beyarkay/vvim/img/2021-06-29 plots/b_500ms.png

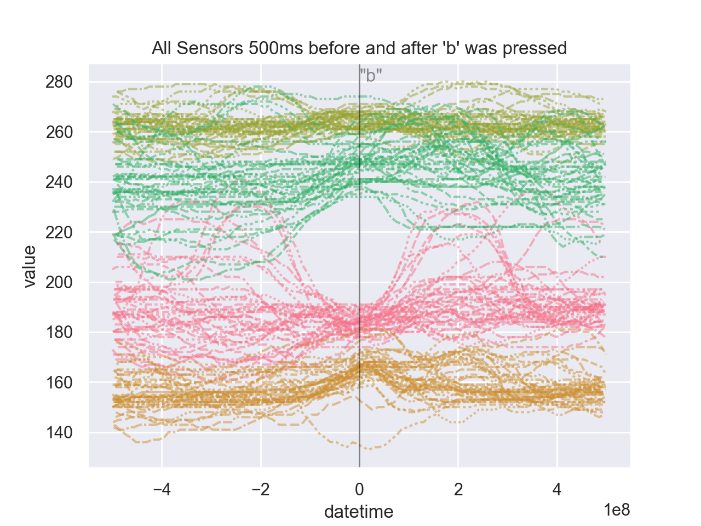
img/2021-06-29 plots/b_500ms.png
