beyarkay/vvim/img/2021-06-29 plots/j_500ms.png

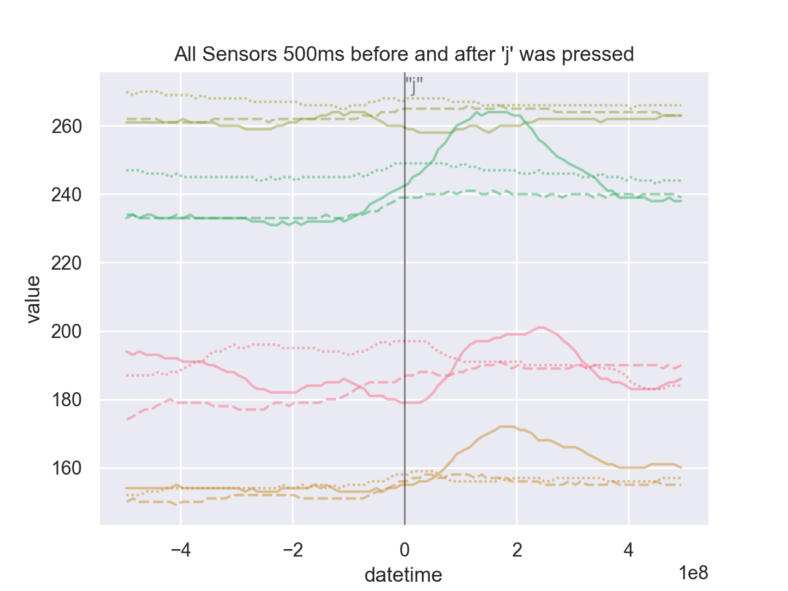
img/2021-06-29 plots/j_500ms.png
