beyarkay/vvim/img/2021-06-29 plots/k_500ms.png

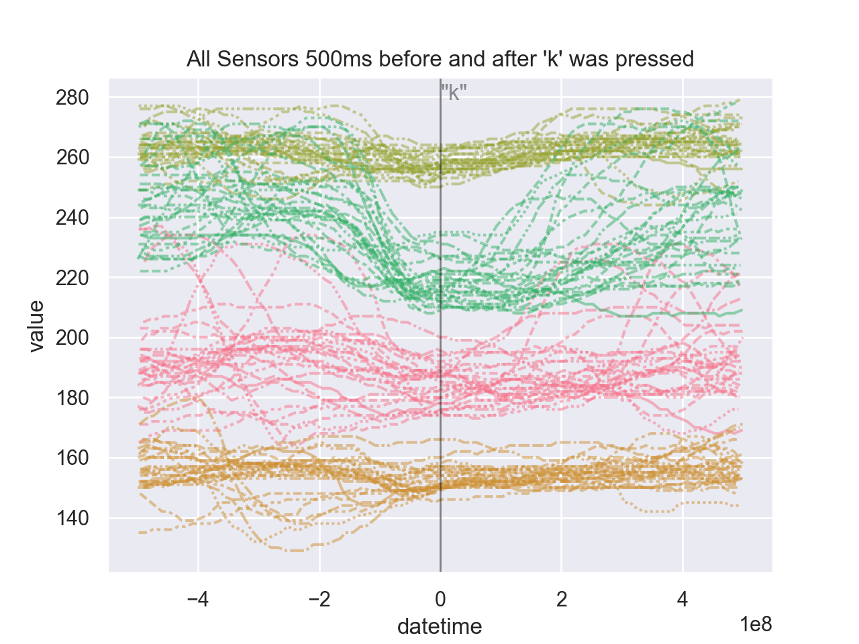
img/2021-06-29 plots/k_500ms.png
