beyarkay/vvim/img/2021-06-29 plots/m_500ms.png

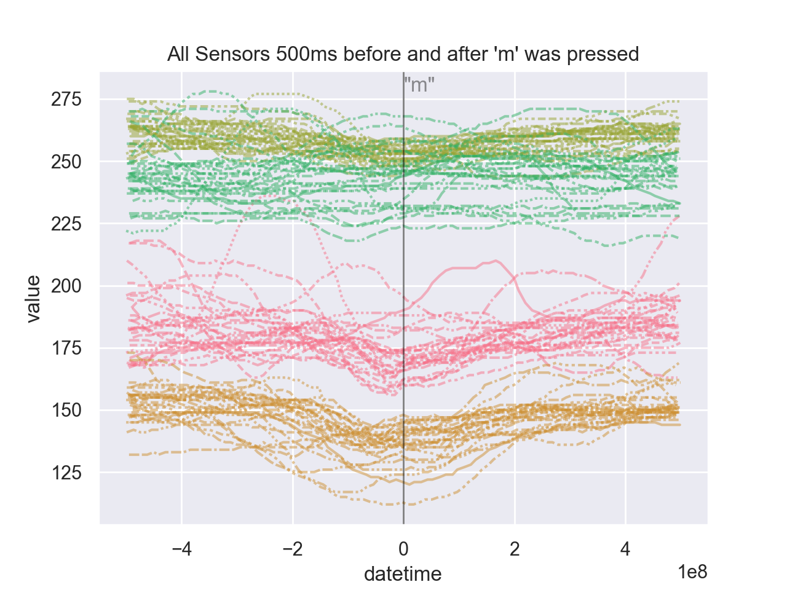
img/2021-06-29 plots/m_500ms.png
