beyarkay/vvim/img/2021-06-30 plots/b_500ms.png

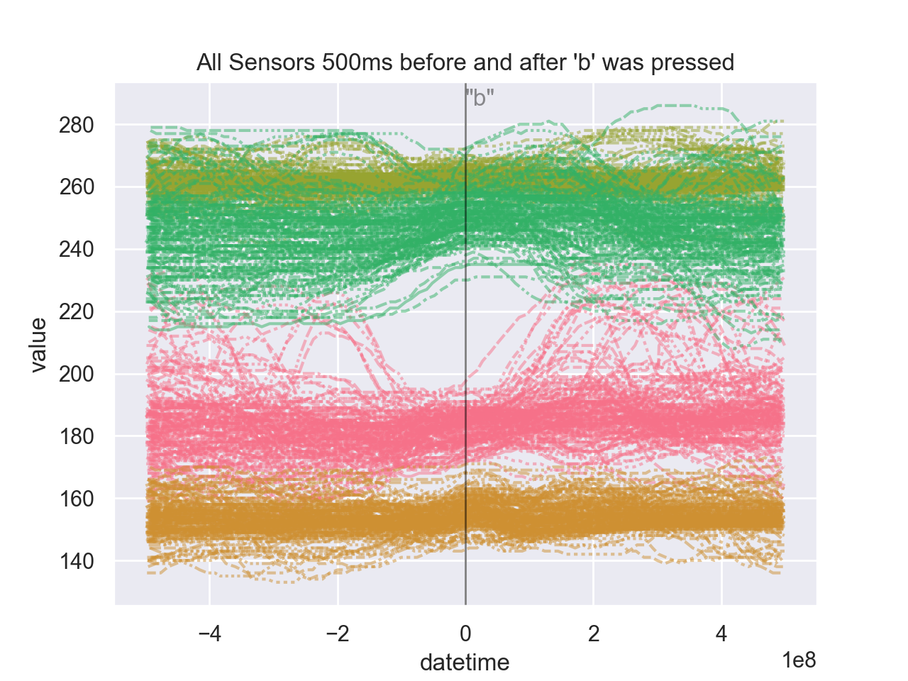
img/2021-06-30 plots/b_500ms.png
