beyarkay/vvim/img/2021-06-30 plots/m_500ms.png

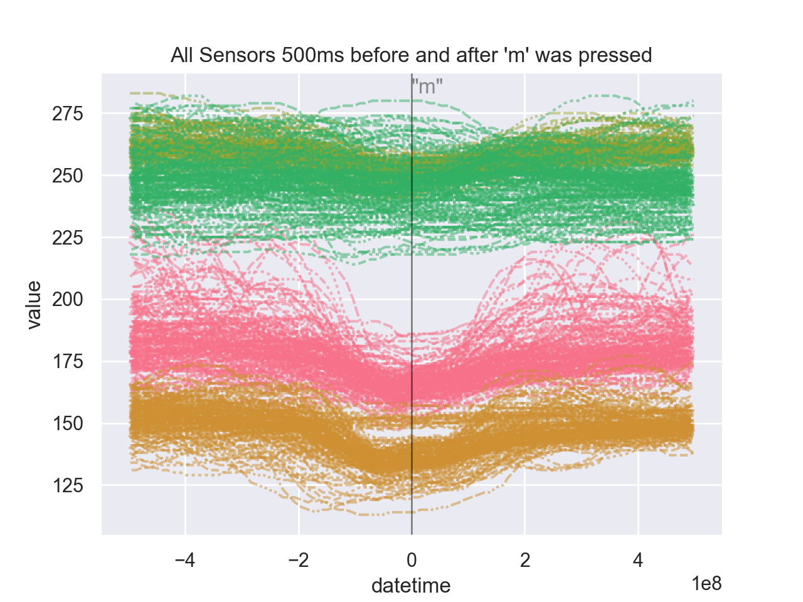
img/2021-06-30 plots/m_500ms.png
