beyarkay/vvim/img/confusion_matrix.png

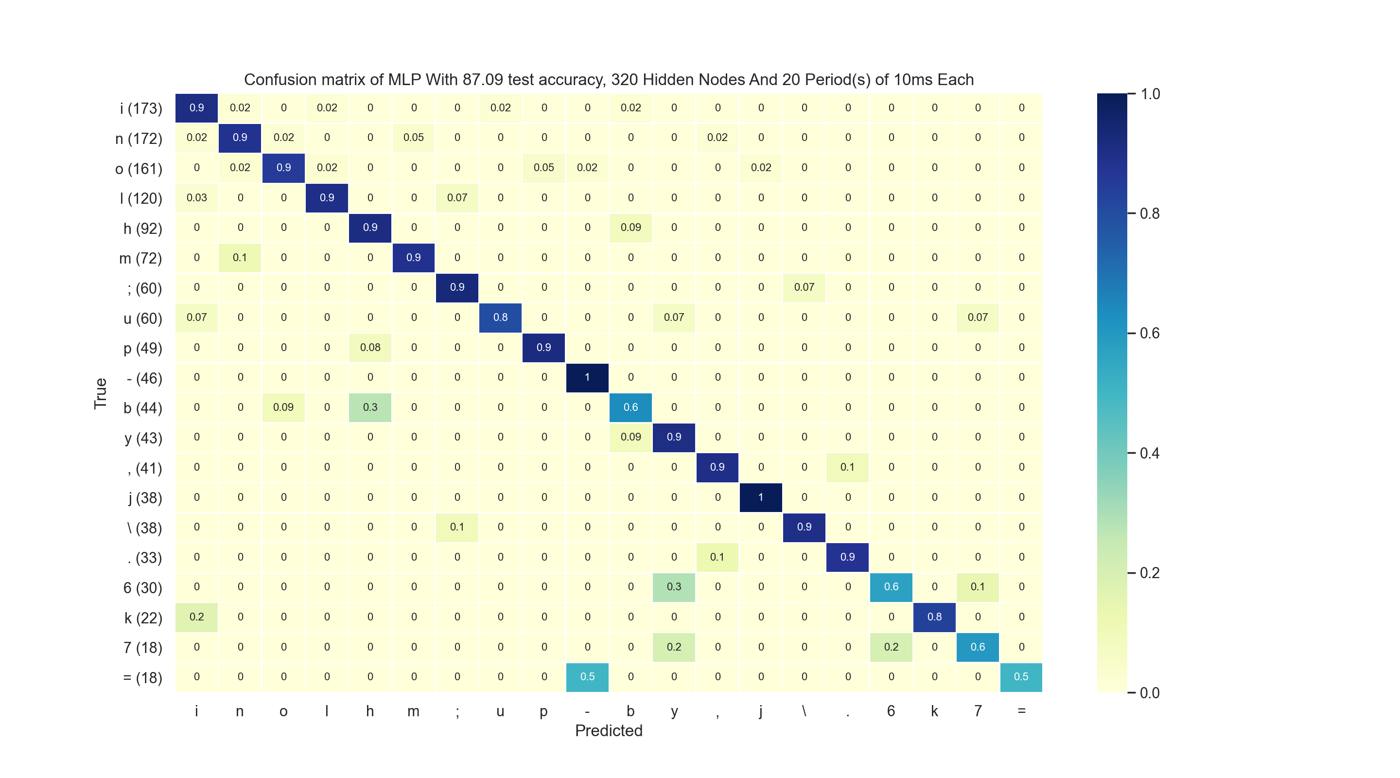
img/confusion_matrix.png
