beyarkay/vvim/img/correlations.png

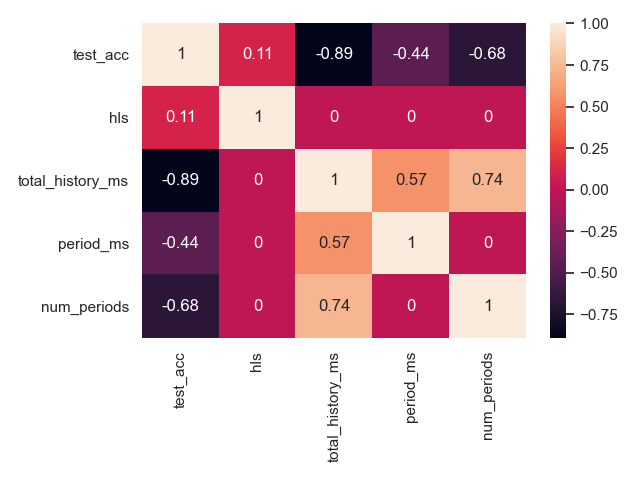
img/correlations.png
