beyarkay/vvim/img/images/confusion.png

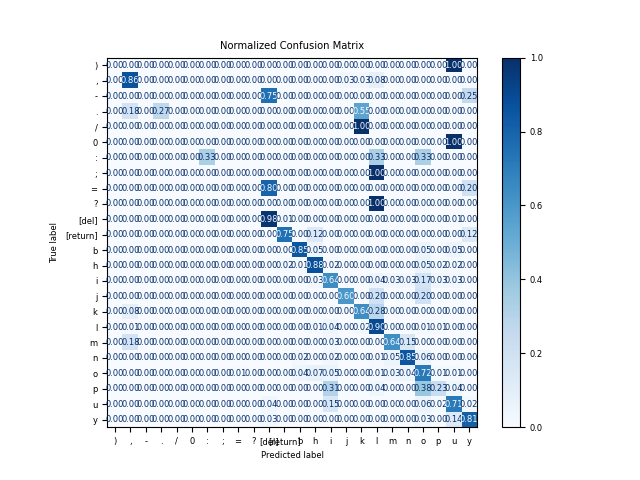
img/images/confusion.png
