beyarkay/vvim/img/images/ConfusionMatrixKNN_3.png

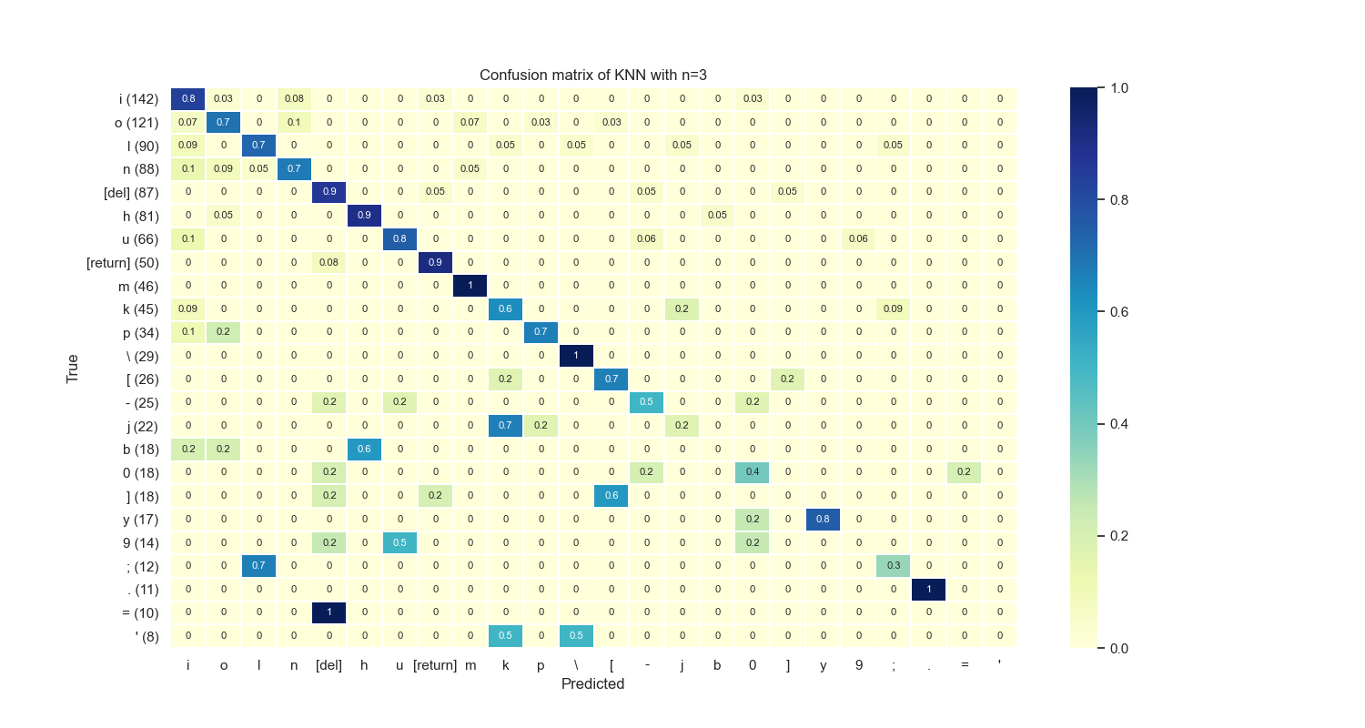
img/images/ConfusionMatrixKNN_3.png
