beyarkay/vvim/img/images/ConfusionMatrixMLP_29.png

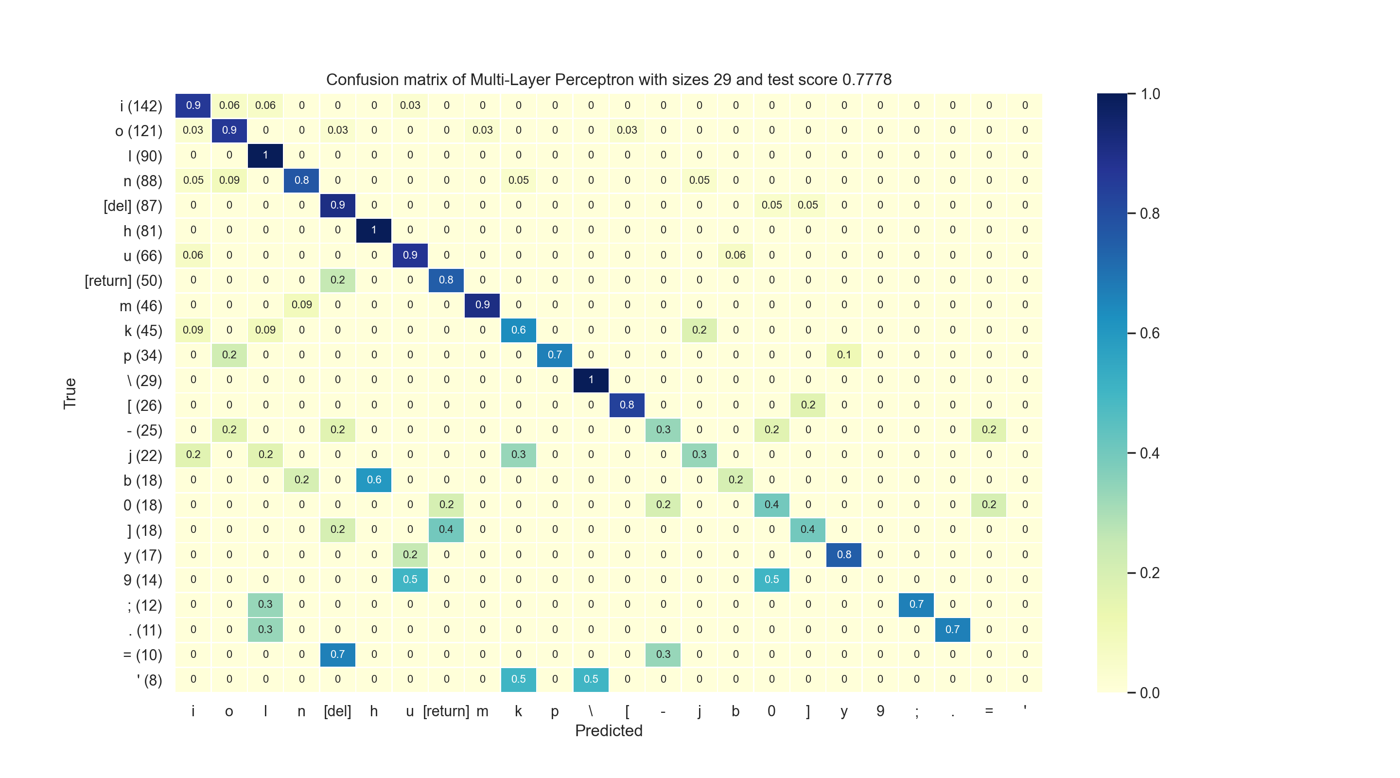
img/images/ConfusionMatrixMLP_29.png
