beyarkay/vvim/img/images/ConfusionMatrixRandomForest.png

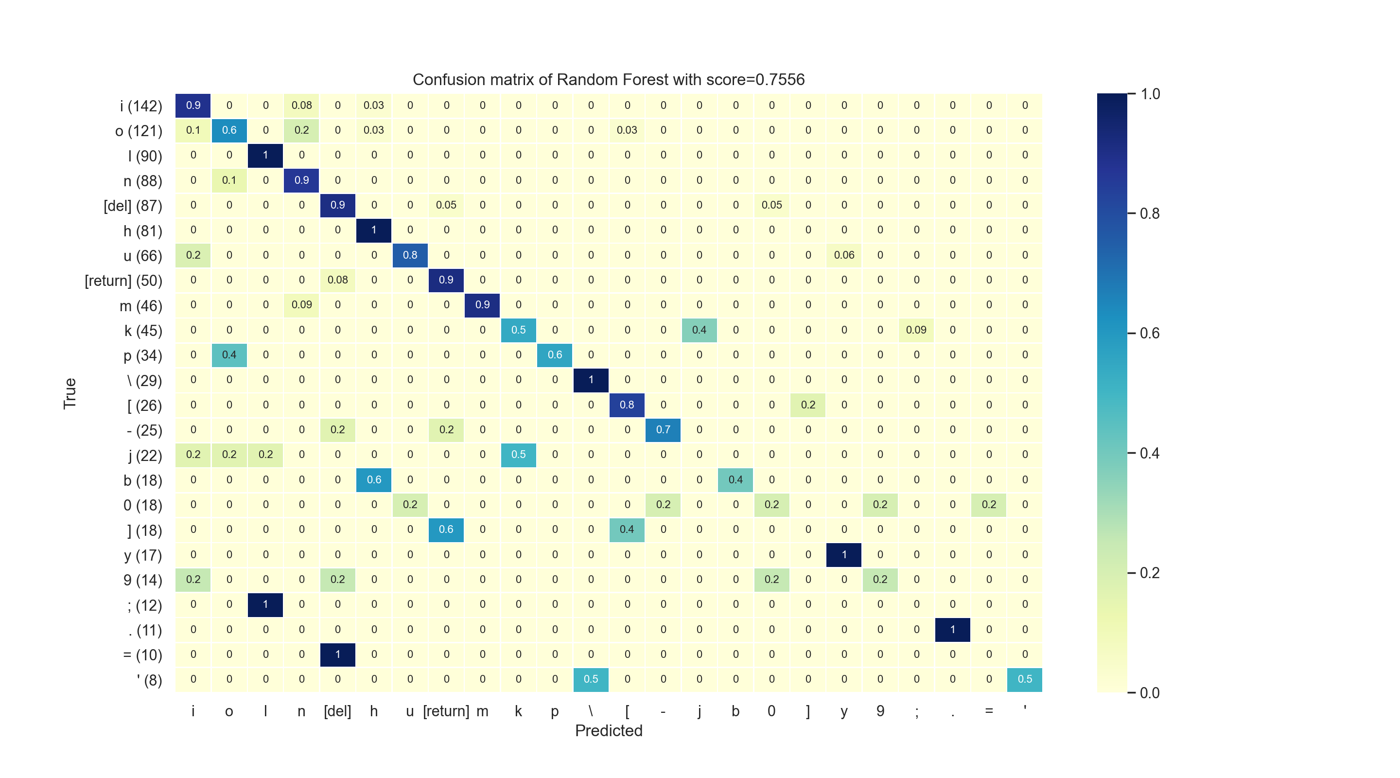
img/images/ConfusionMatrixRandomForest.png
