beyarkay/vvim/img/images/finger_data_more.png

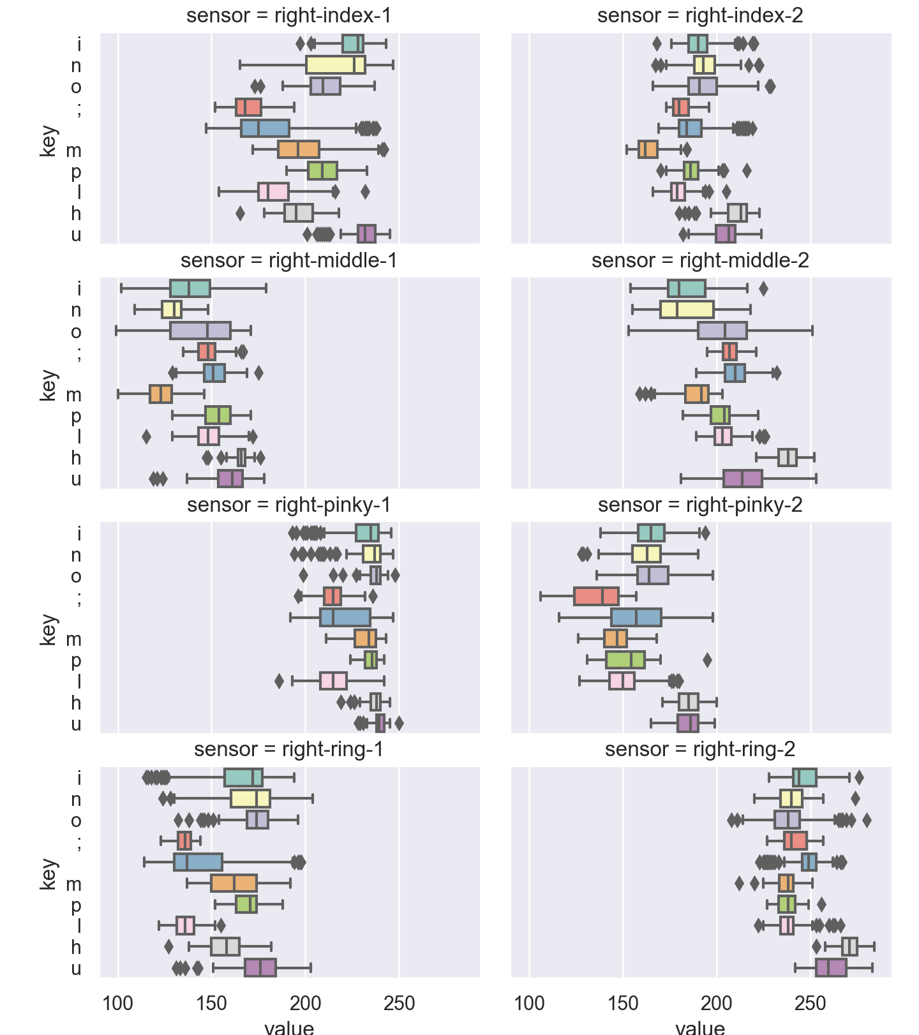
img/images/finger_data_more.png
