beyarkay/vvim/img/images/glove_square.jpg

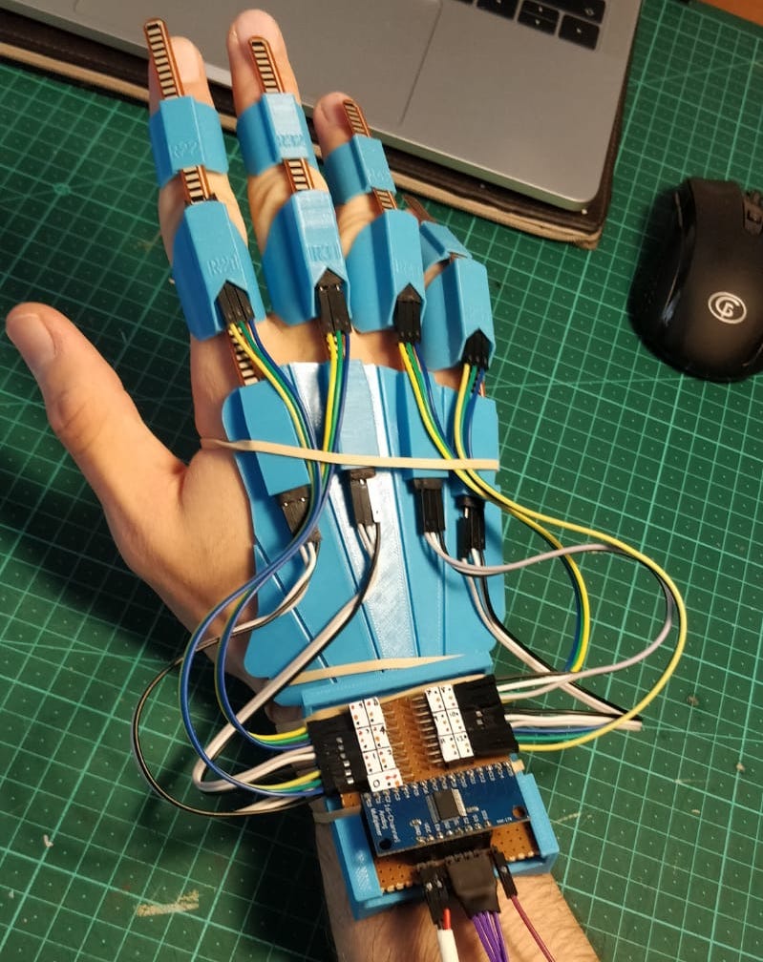
img/images/glove_square.jpg
