beyarkay/vvim/img/images/glove_V0.jpg

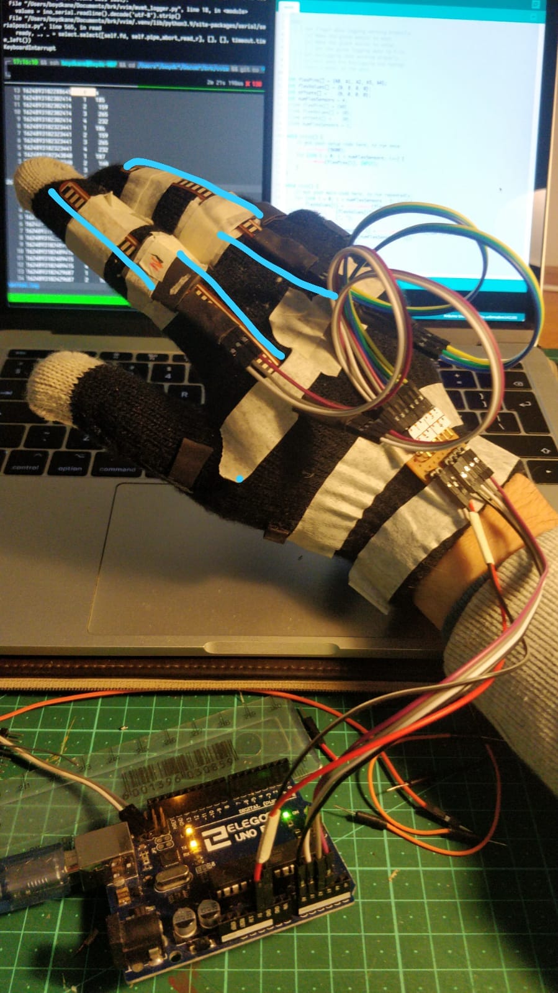
img/images/glove_V0.jpg
