beyarkay/vvim/img/images/polarplot.png

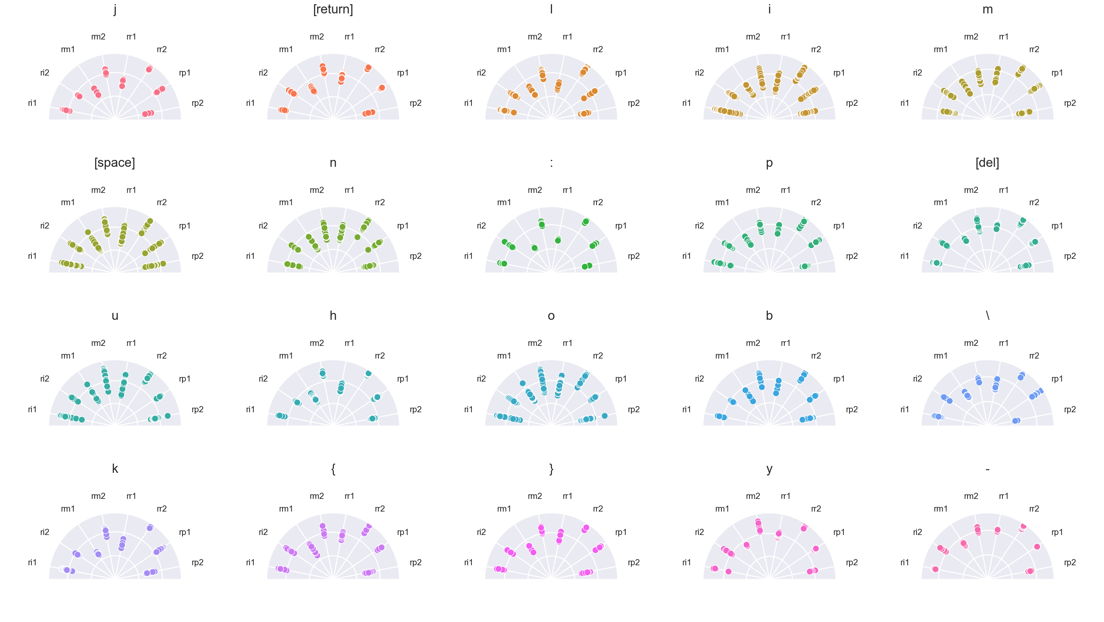
img/images/polarplot.png
