beyarkay/vvim/img/images/small_confusion.jpg

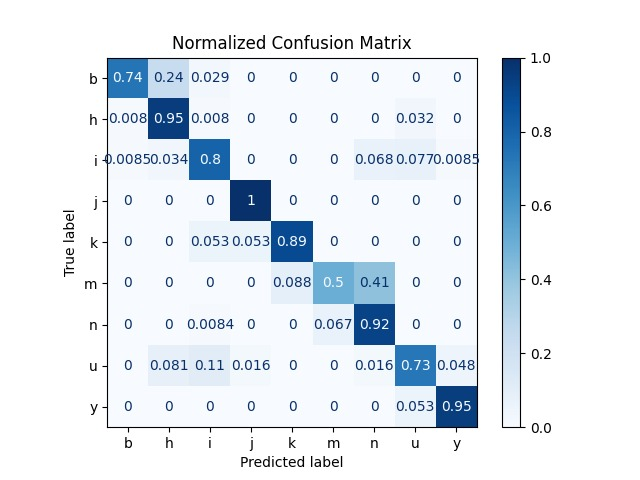
img/images/small_confusion.jpg
