beyarkay/vvim/img/pairwise r=hls,c=period_ms,x=num_periods.png

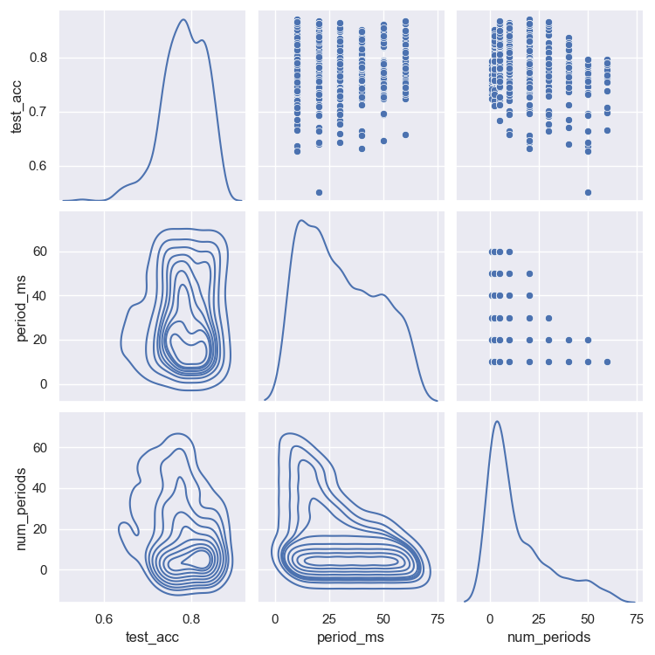
img/pairwise r=hls,c=period_ms,x=num_periods.png
