beyarkay/vvim/img/plots/[_500ms.png

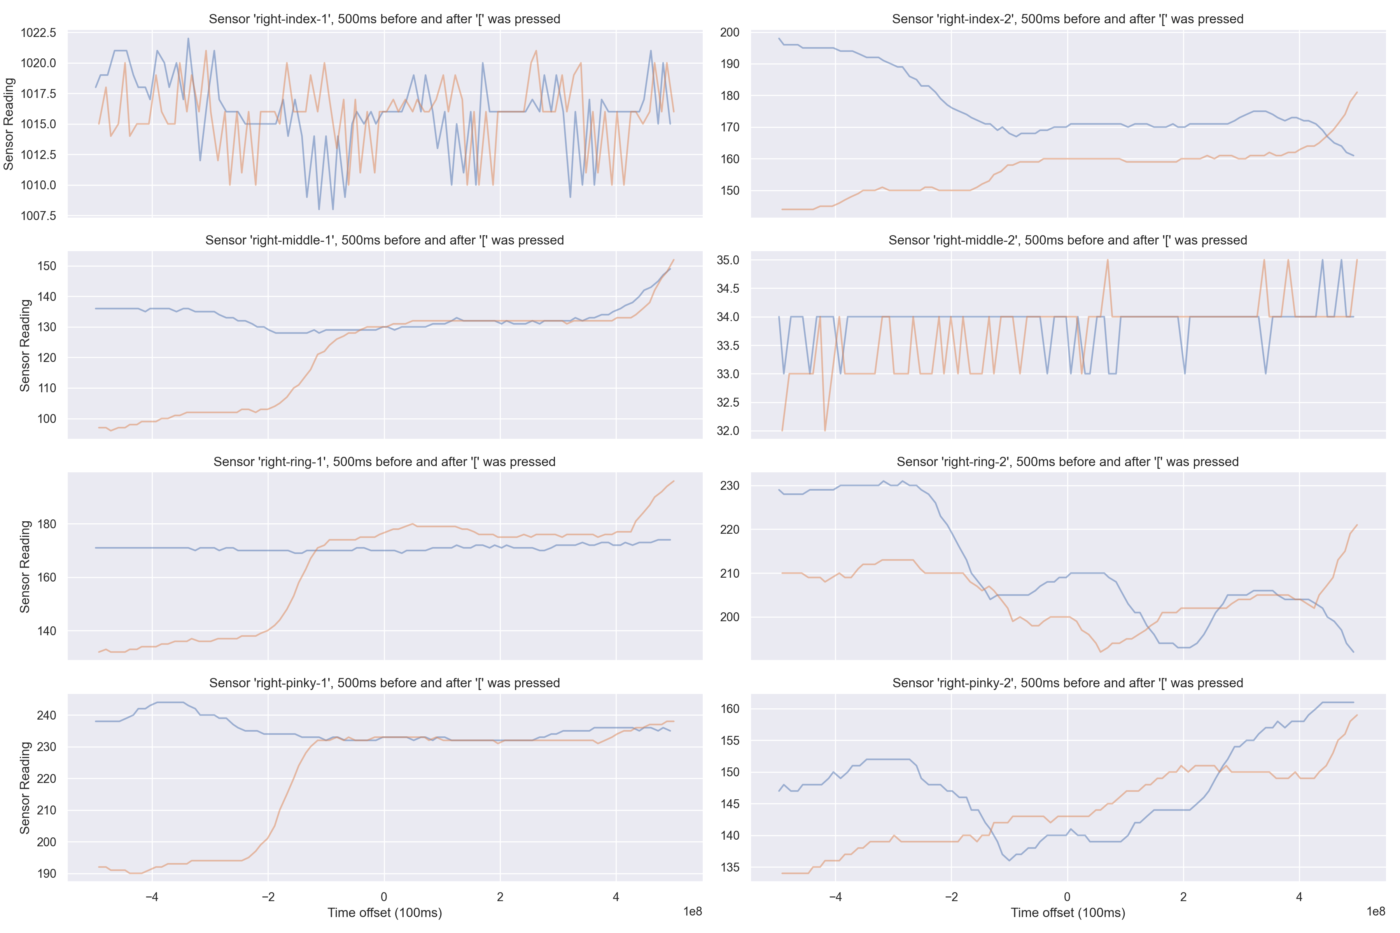
img/plots/[_500ms.png
