beyarkay/vvim/img/plots/b_500ms.png

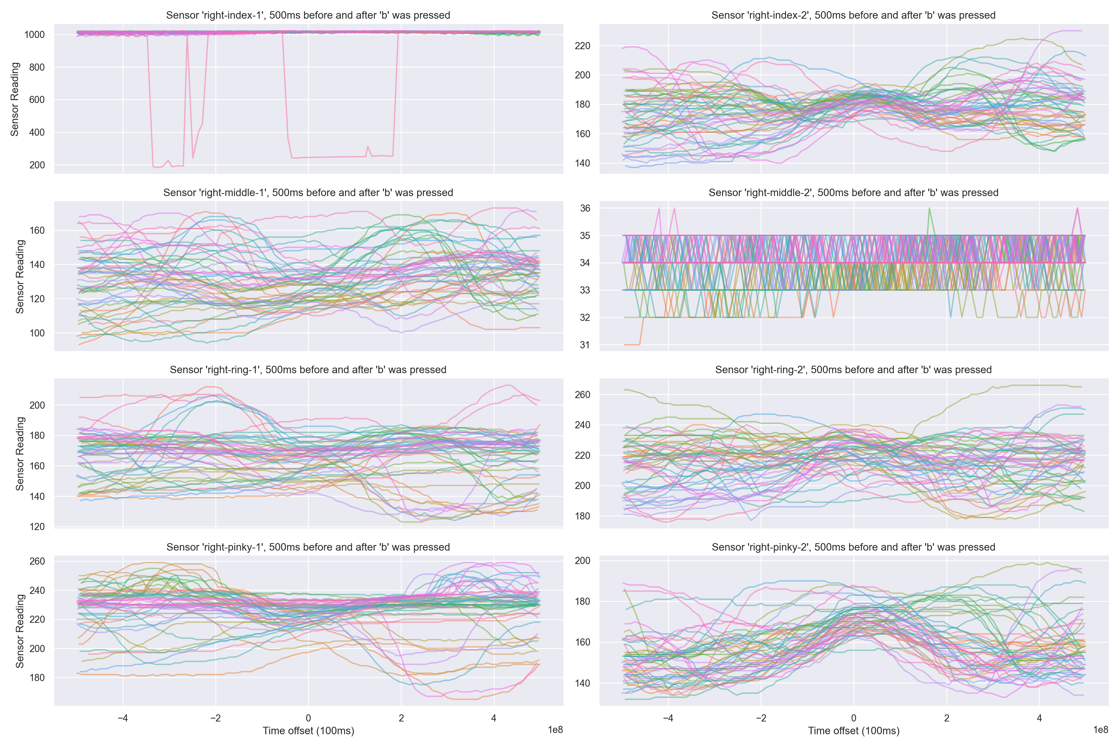
img/plots/b_500ms.png
