beyarkay/vvim/img/plots/n_500ms.png

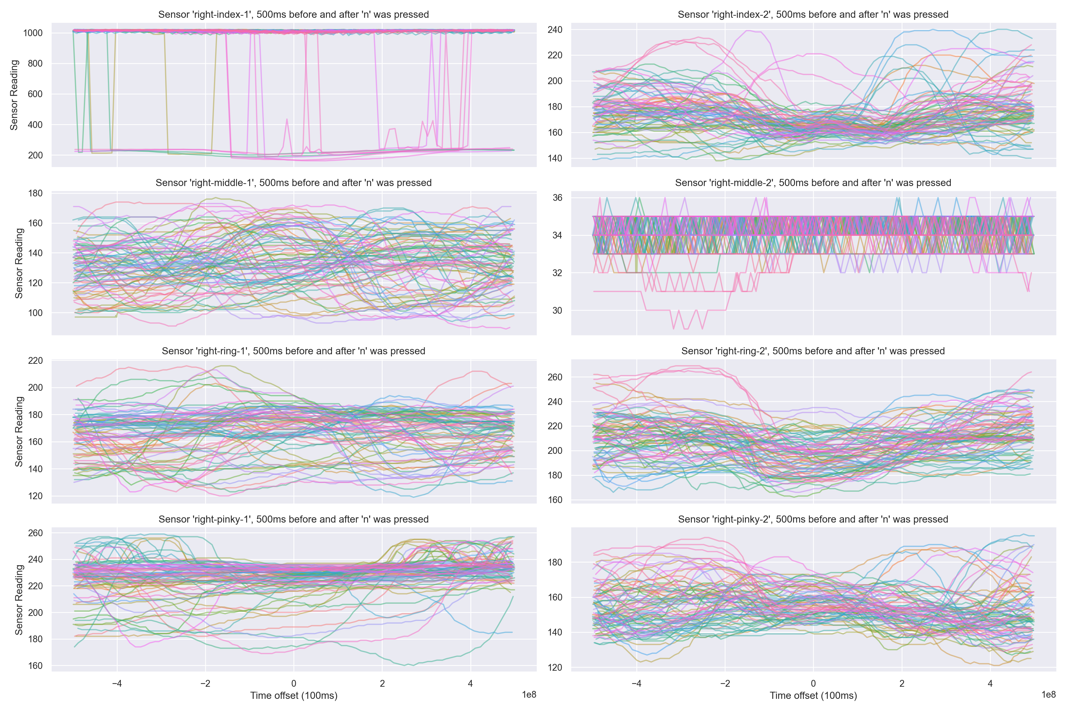
img/plots/n_500ms.png
