beyarkay/vvim/img/plots/p_500ms.png

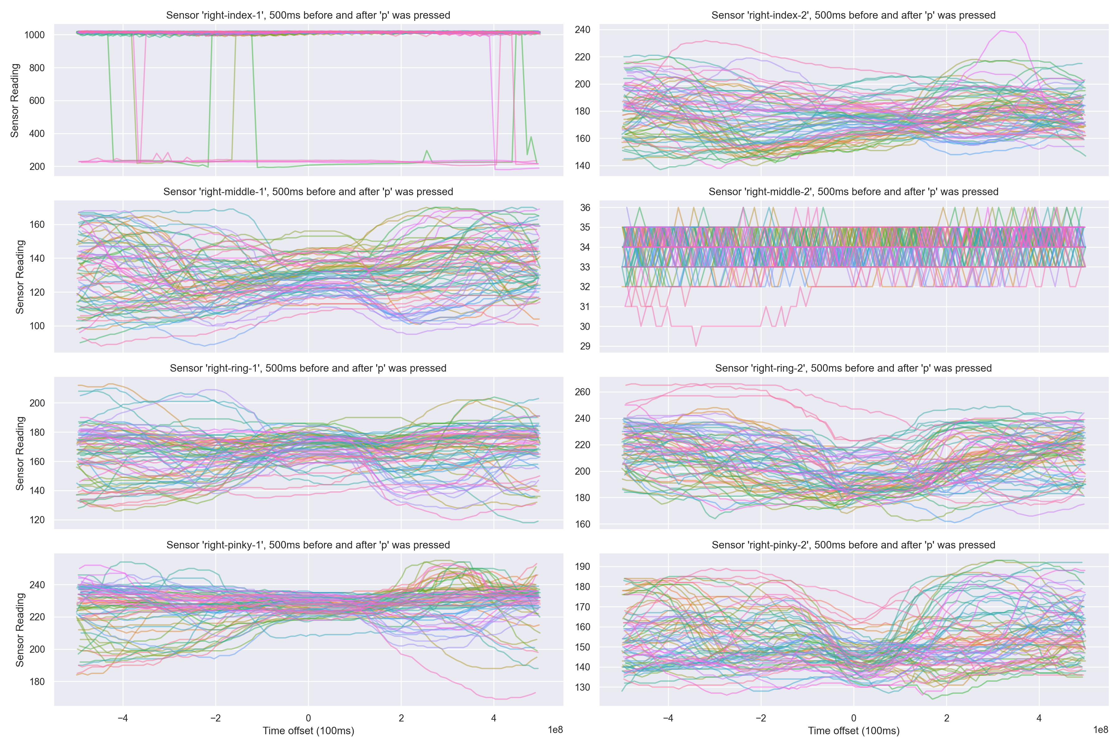
img/plots/p_500ms.png
