beyarkay/vvim/img/plots/sensors_hist.png

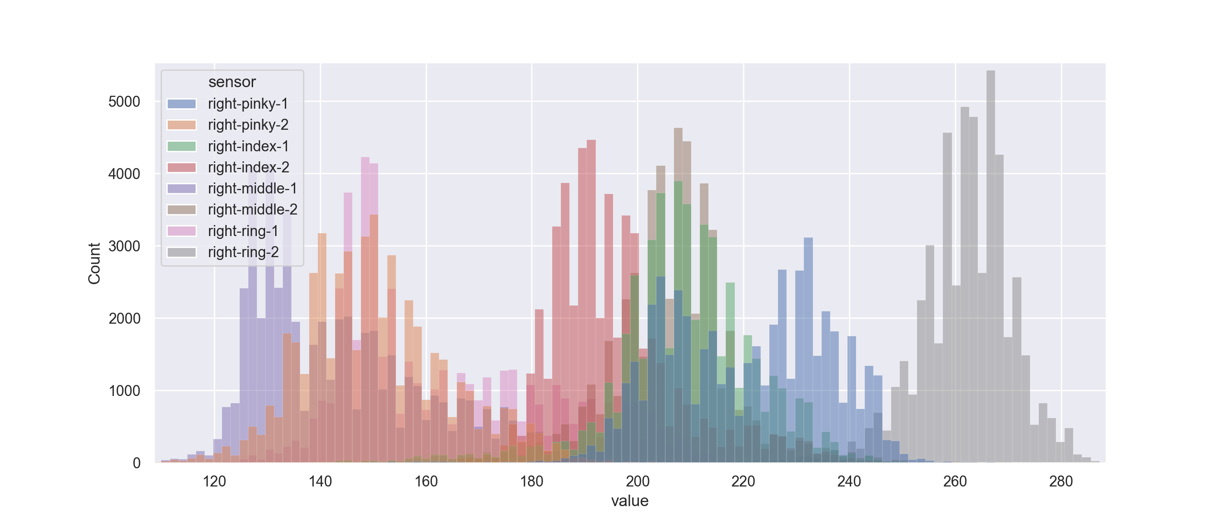
img/plots/sensors_hist.png
