beyarkay/vvim/img/plots/y_500ms.png

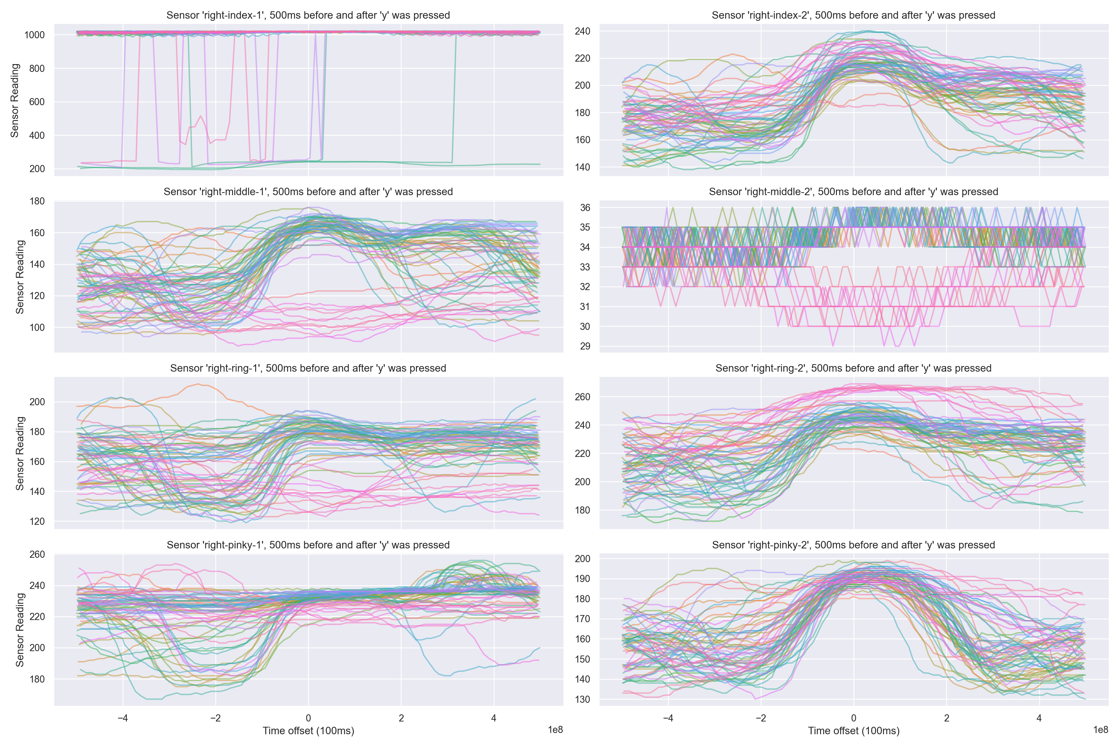
img/plots/y_500ms.png
