beyarkay/vvim/img/test_accuracy vs r=hls,c=period_ms,x=num_periods.png

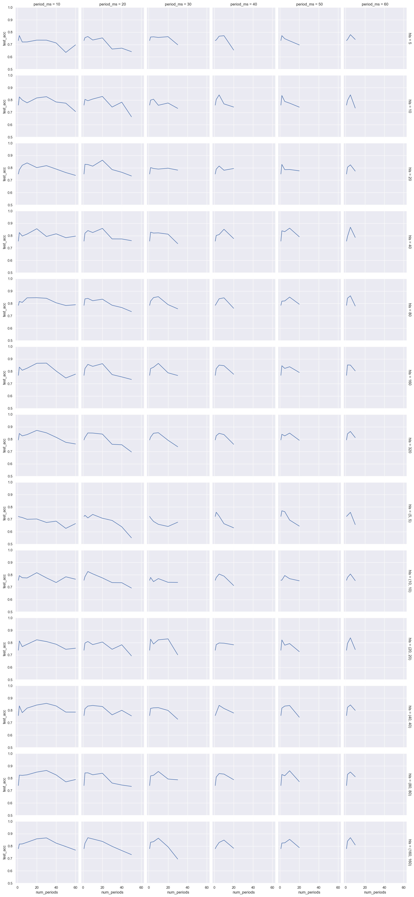
img/test_accuracy vs r=hls,c=period_ms,x=num_periods.png
