beyarkay/vvim/img/test_accuracy vs r=num_periods,c=hls,x=period_ms.png

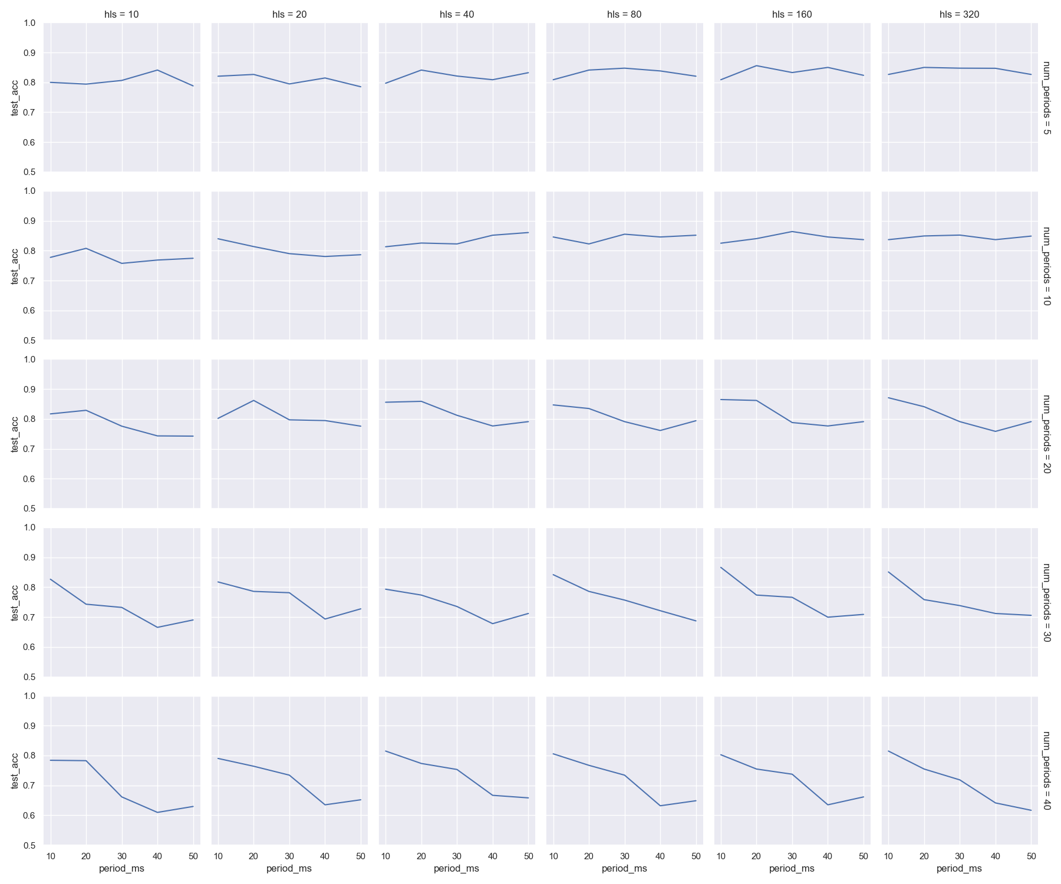
img/test_accuracy vs r=num_periods,c=hls,x=period_ms.png
