beyarkay/vvim/img/test_accuracy vs r=num_periods,c=hls,x=total_history_ms.png

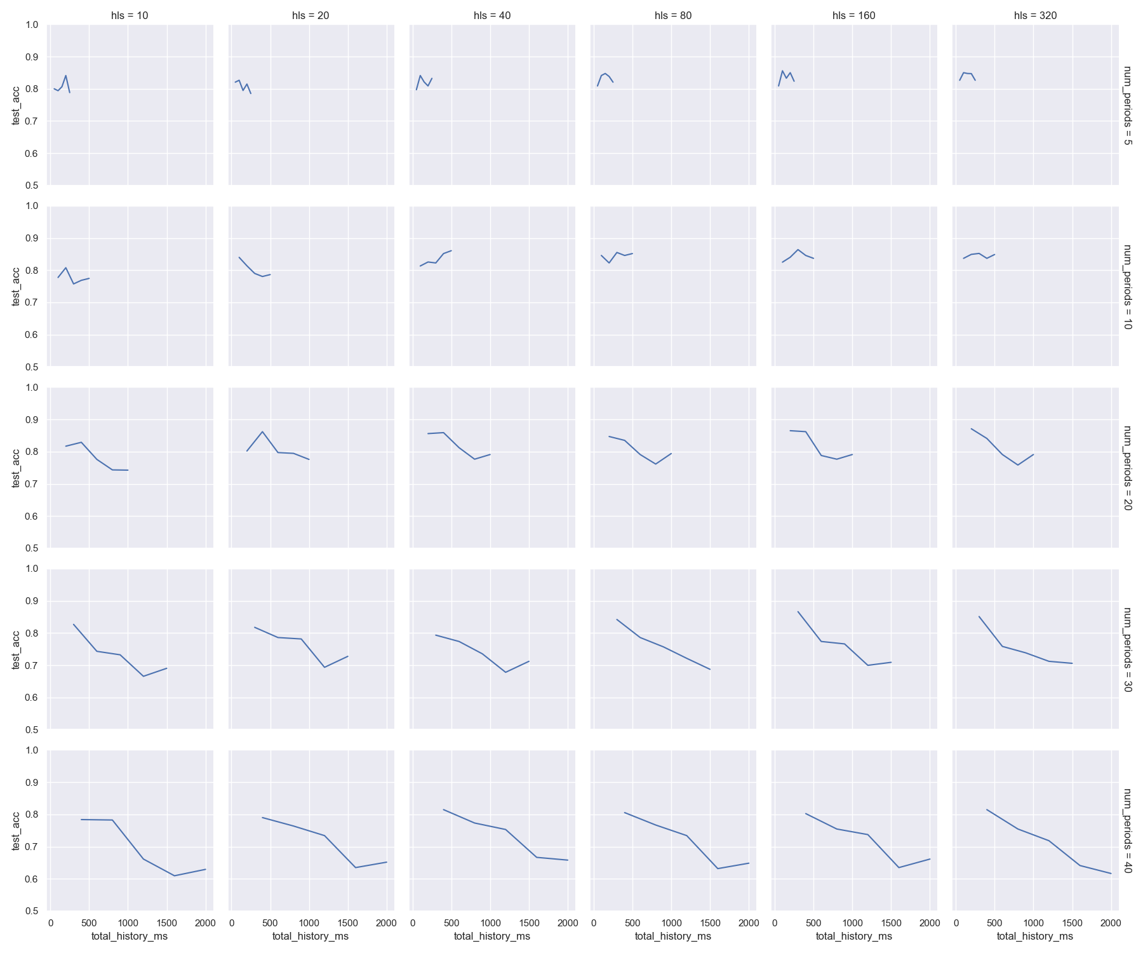
img/test_accuracy vs r=num_periods,c=hls,x=total_history_ms.png
