beyarkay/vvim/img/test_accuracy vs r=period_ms,c=hls,x=total_history_ms.png

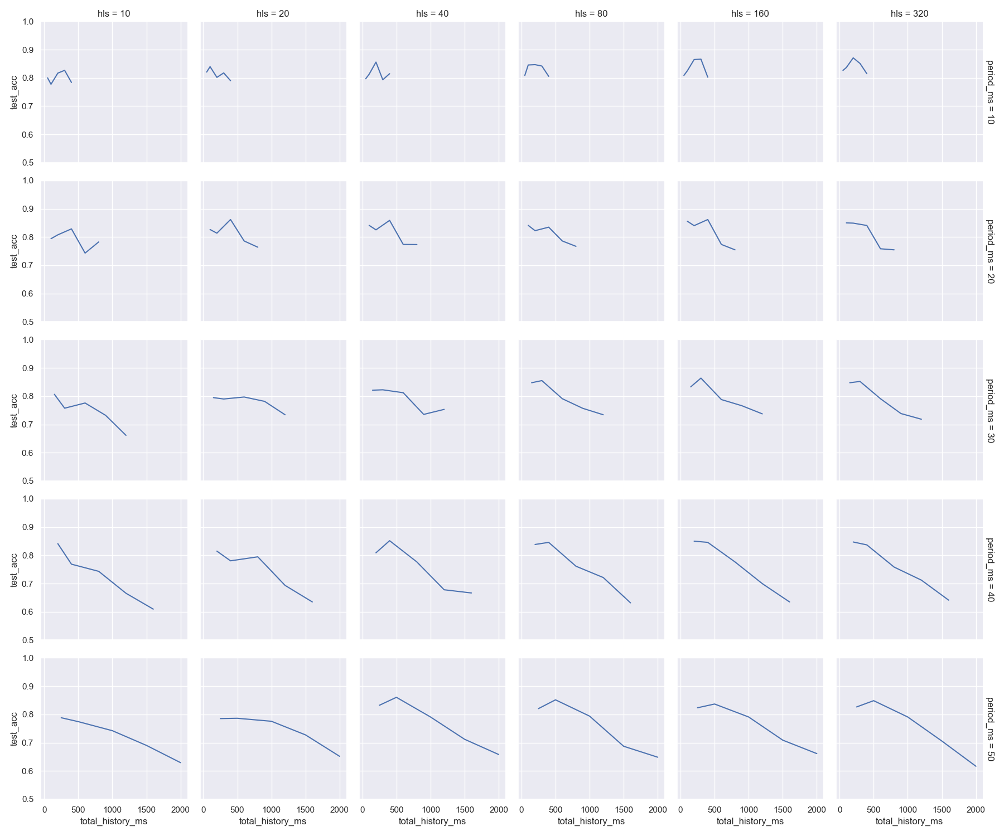
img/test_accuracy vs r=period_ms,c=hls,x=total_history_ms.png
