beyarkay/vvim/img/test_accuracy vs r=period_ms,c=num_periods,x=hls.png

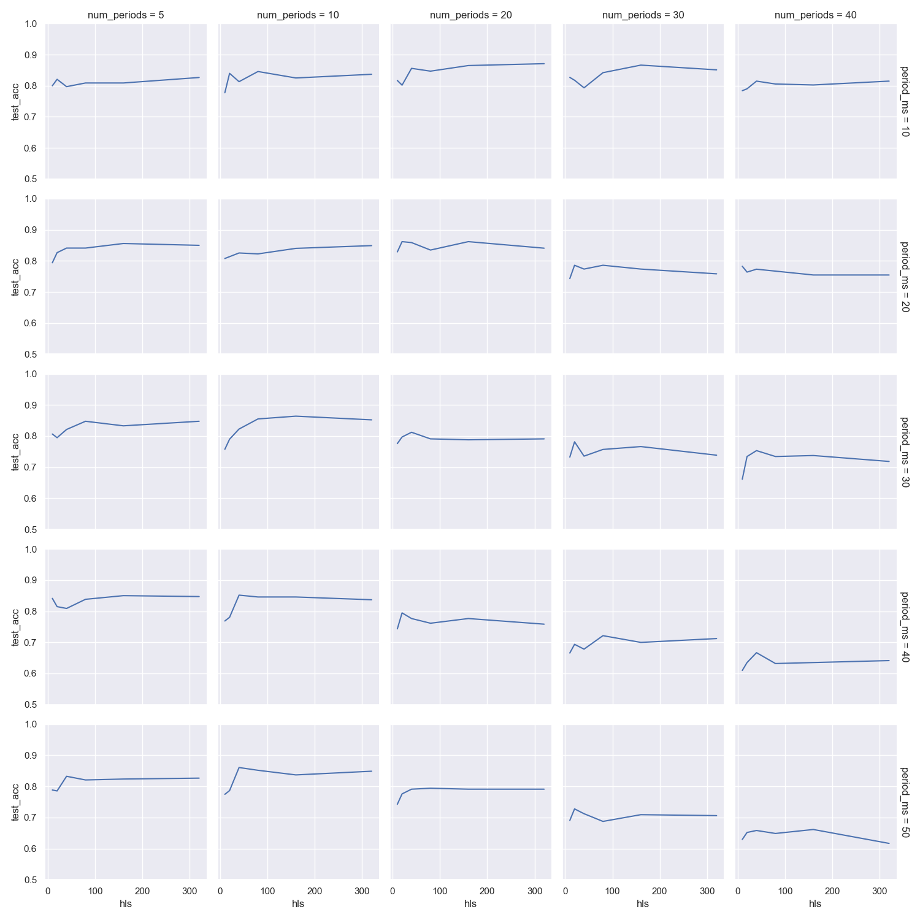
img/test_accuracy vs r=period_ms,c=num_periods,x=hls.png
