beyarkay/vvim/(commit log)

2021-06-30 Add in descriptions for which fingers often press which keys
2021-07-08 Update README with current status of 3d printing
2021-07-13 Record and graph more data with 8 sensors
2021-08-27 Cleaning up unused files
    [glove_long_format.csv]
2022-02-22 Redo directory structure
    [glove_long_format.csv]
